vbnbharath/WSN/GPSLocalization/README.md

Scraps for testing GPS localization..
Approximate approach from "Localization of Wireless Sensor Networks with a Mobile Beacon by Mihail L. Sichitiu and Vaidyanathan Ramadurai"
http://ieeexplore.ieee.org/stamp/stamp.jsp?arnumber=1392104
Computer-side code written in Python
