vbnbharath/WSN/Documentation/latex/pin_defs_8h.tex

\hypertarget{pin_defs_8h}{}\section{pin\+Defs.\+h File Reference}
\label{pin_defs_8h}\index{pin\+Defs.\+h@{pin\+Defs.\+h}}
\subsection*{Macros}
\begin{DoxyCompactItemize}
\item 
\#define \hyperlink{pin_defs_8h_add3ca9eefe3b5b754426f51d3043e579}{True}~1
\item 
\#define \hyperlink{pin_defs_8h_a306ebd41c0cd1303b1372c6153f0caf8}{False}~0
\end{DoxyCompactItemize}

\subsection{Macro Definition Documentation}
\hypertarget{pin_defs_8h_a306ebd41c0cd1303b1372c6153f0caf8}{}\index{pin\+Defs.\+h@{pin\+Defs.\+h}!False@{False}}
\index{False@{False}!pin\+Defs.\+h@{pin\+Defs.\+h}}
\subsubsection[{False}]{\setlength{\rightskip}{0pt plus 5cm}\#define False~0}\label{pin_defs_8h_a306ebd41c0cd1303b1372c6153f0caf8}
\hypertarget{pin_defs_8h_add3ca9eefe3b5b754426f51d3043e579}{}\index{pin\+Defs.\+h@{pin\+Defs.\+h}!True@{True}}
\index{True@{True}!pin\+Defs.\+h@{pin\+Defs.\+h}}
\subsubsection[{True}]{\setlength{\rightskip}{0pt plus 5cm}\#define True~1}\label{pin_defs_8h_add3ca9eefe3b5b754426f51d3043e579}
