vbnbharath/WSN/hardware/antenna_node/sensor_node_schematic.pdf

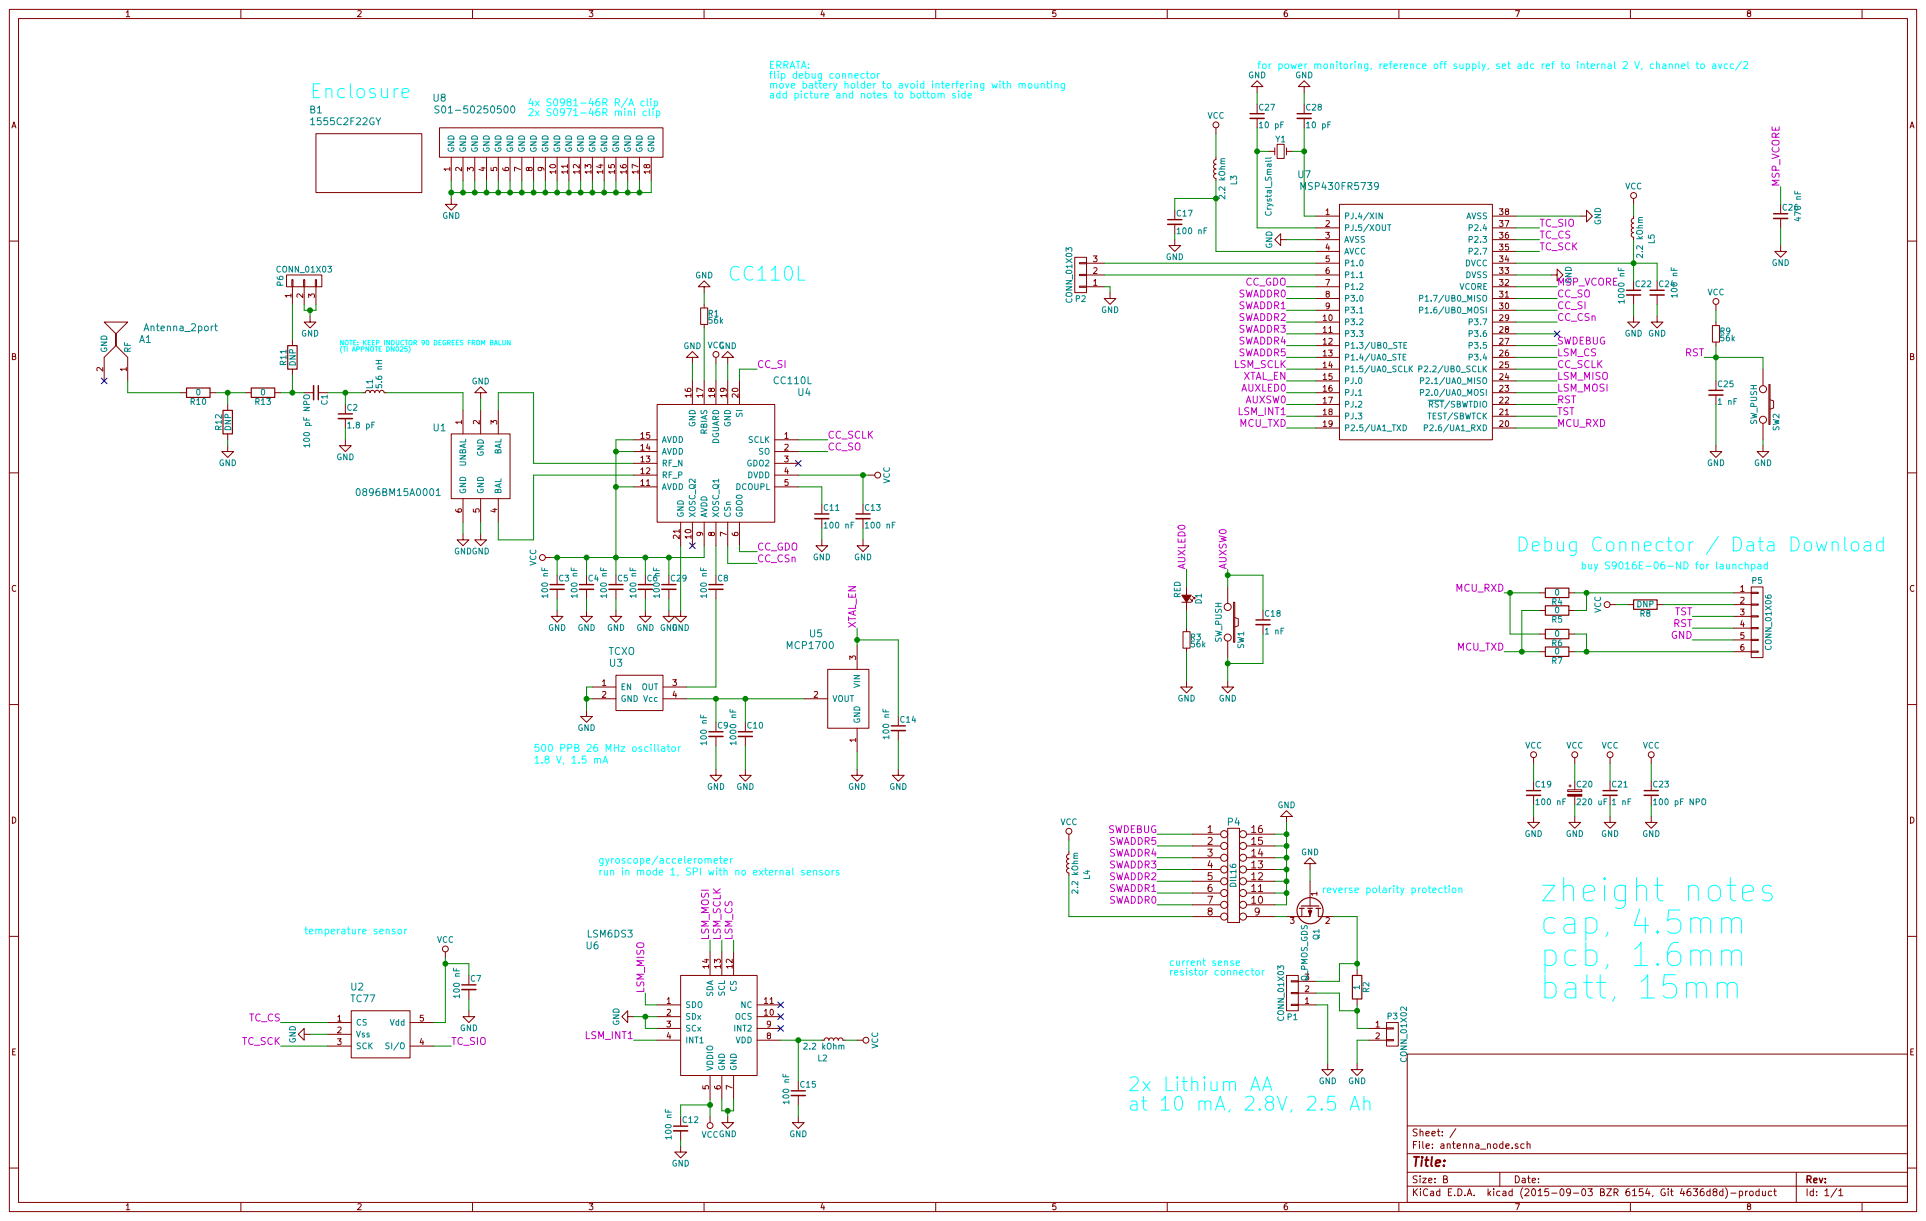
[picture p1: page 1]

for power monitoring, reference off supply, set adc ref to internal 2 V, channel to avcc/2 LSM_MISO

ERRATA:
flip debug connector
move battery holder to avoid interfering with mounting
add picture and notes to bottom side

9 GND 10 GND 11 GND 12 GND 13 GND 14 GND 15 GND 16 GND 17 GND 18 U8S01-50250500 GND

9 XOSC_Q2 10 SI 20 AVDD 11 GND 21 RF_P 12 RF_N 13 AVDD 14 AVDD 15 GND 16 RBIAS 17 DGUARD 18 GND 19U4 CC110L CC_GDO

NOTE: KEEP INDUCTOR 90 DEGREES FROM BALUN

Debug Connector / Data Download

C5 100 nFC3 100 nF GND GND GND

buy S9016E-06-ND for launchpad

run in mode 1, SPI with no external sensors LSM_MOSI LSM_SCLK LSM_CS temperature sensor
