vbnbharath/WSN/hardware/gps_breakout/gps_breakout.kicad_pcb

## KiCad design hardware/gps_breakout/gps_breakout.kicad_pcb (2015-10-24)

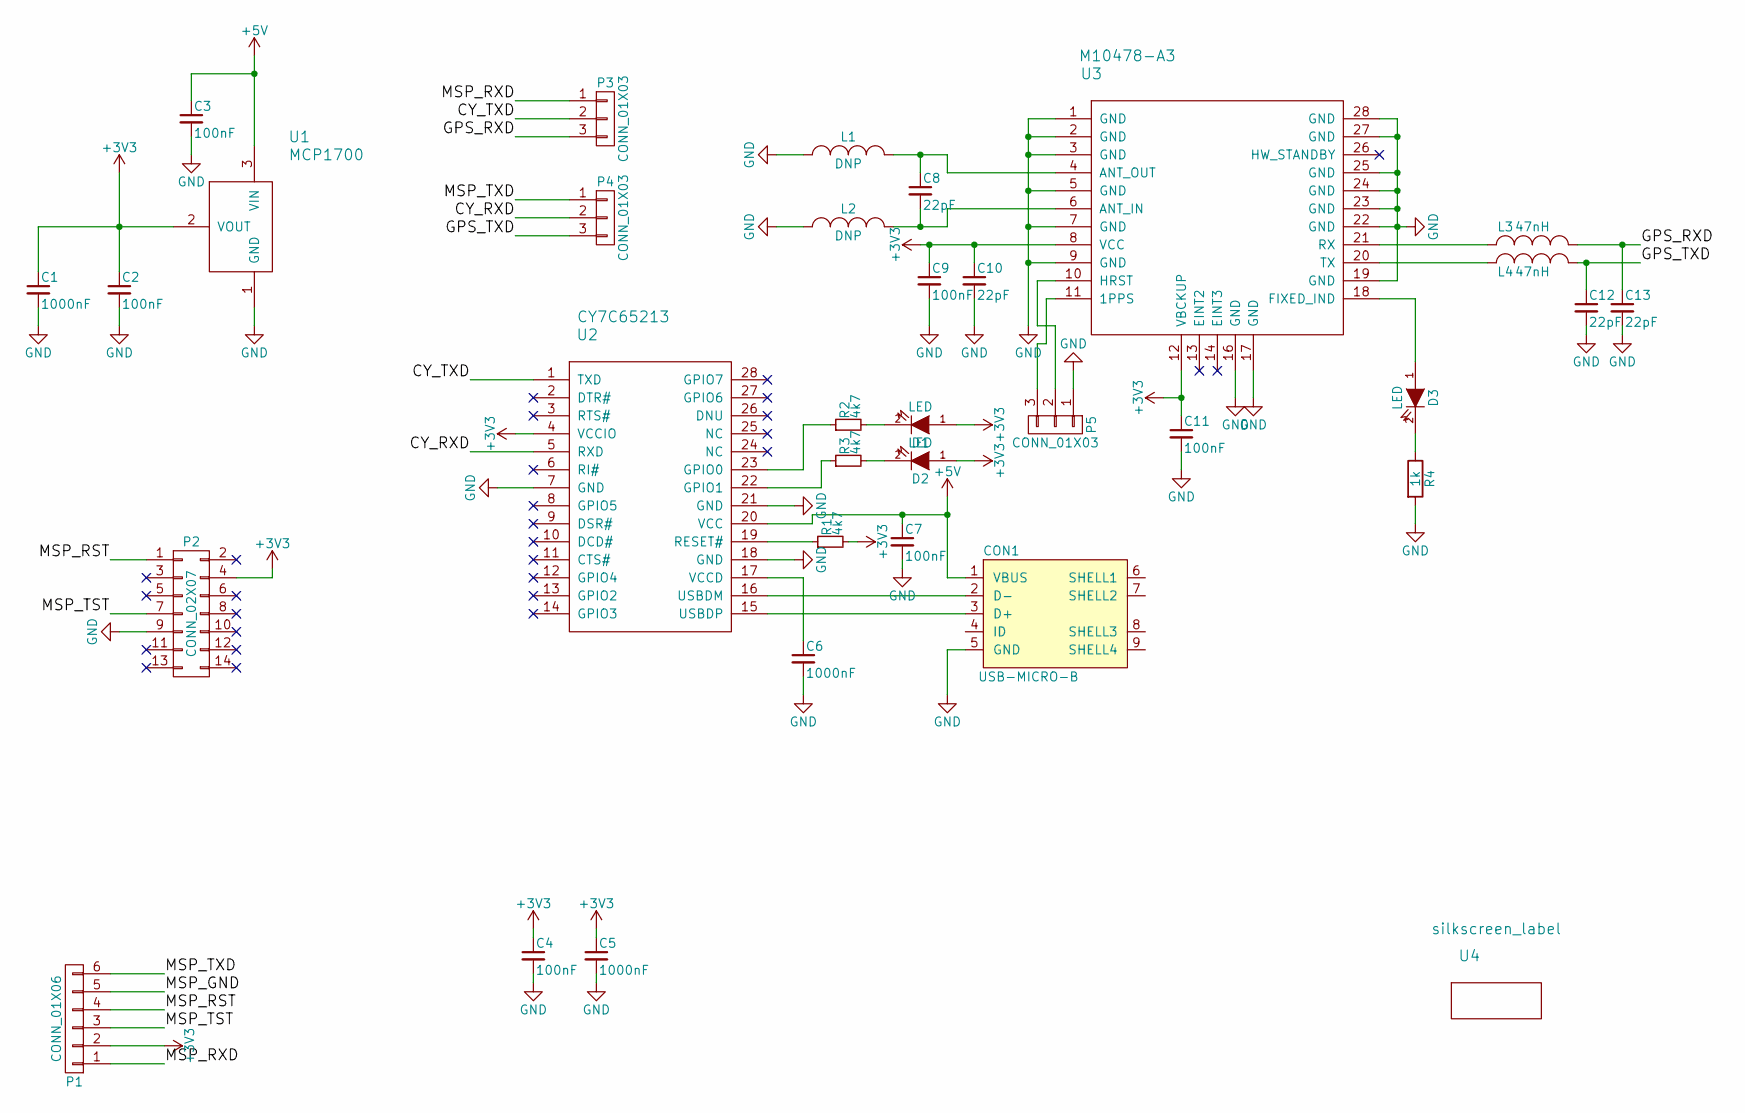
[picture p2: schematic gps_breakout.sch]

Parts:
C1, C5, C6: 1000nF; C_0603
C2, C3, C4, C7, C9, C11: 100nF; C_0603
C8, C10, C12, C13: 22pF; C_0603
CON1: USB-MICRO-B; USB_Mini-B
D1, D2, D3: LED; LED-0603
L1, L2: DNP; R_0603
L3, L4: 47nH; R_0603
P1: CONN_01X06; LPPB061NGCN-RC
P2: CONN_02X07; CONN_MSPJTAG
P3, P4, P5: CONN_01X03; JMP_HDR
R1, R2, R3: 4k7; R_0603
R4: 1k; R_0603
U1: MCP1700; SOT89-3_Housing
U2: CY7C65213; SSOP-28_5.3x10.2mm_Pitch0.65mm
U3: M10478-A3; gps_radionova
U4: silkscreen_label; gunter

Connections:
+3V3: C1.1, C2.1, C4.1, C5.1, C9.1, C10.1, C11.1, D1.1 (A), D2.1 (A), P1.2, P2.4, R1.2, U1.2 (VOUT), U2.4 (VCCIO), U3.8 (VCC), U3.12 (VBCKUP)
+5V: C3.1, C7.1, CON1.1 (VBUS), U1.3 (VIN), U2.20 (VCC)
/CY_RXD: P4.2, U2.5 (RXD)
/CY_TXD: P3.2, U2.1 (TXD)
/GPS_RXD: C13.1, L3.2, P3.3
/GPS_TXD: C12.1, L4.2, P4.3
/MSP_GND: P1.5
/MSP_RST: P1.4, P2.1
/MSP_RXD: P1.1, P3.1
/MSP_TST: P1.3, P2.7
/MSP_TXD: P1.6, P4.1
GND: C1.2, C2.2, C3.2, C4.2, C5.2, C6.2, C7.2, C9.2, C10.2, C11.2, C12.2, C13.2, CON1.5 (GND), L1.1, L2.1, P2.9, P5.1, R4.2, U1.1 (GND), U2.7 (GND), U2.18 (GND), U2.21 (GND), U3.1 (GND), U3.2 (GND), U3.3 (GND), U3.5 (GND), U3.7 (GND), U3.9 (GND), U3.16 (GND), U3.17 (GND), U3.19 (GND), U3.22 (GND), U3.23 (GND), U3.24 (GND), U3.25 (GND), U3.27 (GND), U3.28 (GND)
unnamed: C6.1, U2.17 (VCCD)
unnamed: C8.1, L1.2, U3.4 (ANT_OUT)
unnamed: C8.2, L2.2, U3.6 (ANT_IN)
unnamed: CON1.2 (D-), U2.16 (USBDM)
unnamed: CON1.3 (D+), U2.15 (USBDP)
unnamed: D1.2 (K), R2.2
unnamed: D2.2 (K), R3.2
unnamed: D3.1 (A), U3.18 (FIXED_IND)
unnamed: D3.2 (K), R4.1
unnamed: L3.1, U3.21 (RX)
unnamed: L4.1, U3.20 (TX)
unnamed: P5.2, U3.10 (HRST)
unnamed: P5.3, U3.11 (1PPS)
unnamed: R1.1, U2.19 (RESET#)
unnamed: R2.1, U2.23 (GPIO0)
unnamed: R3.1, U2.22 (GPIO1)

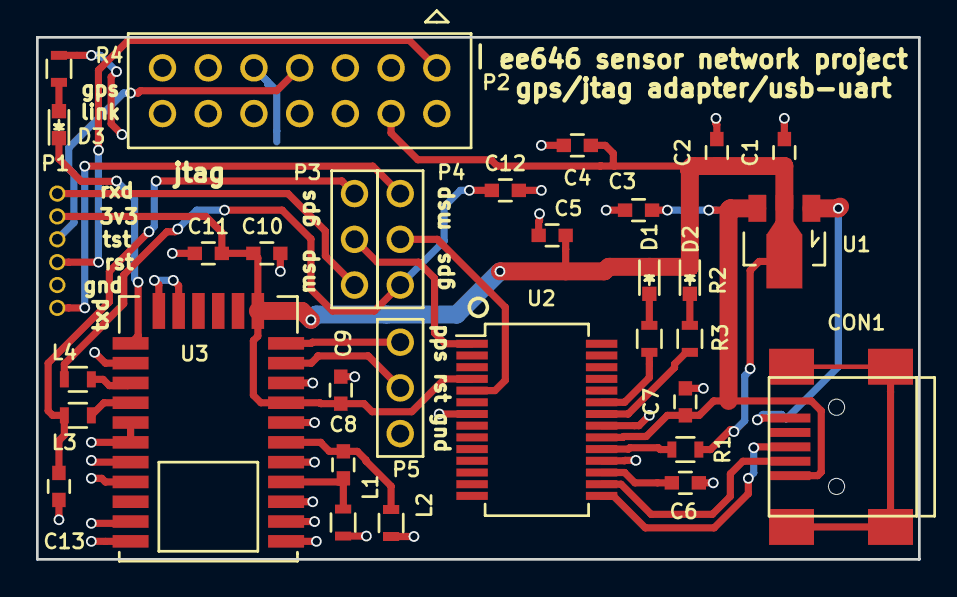
[picture p3: board gps_breakout.kicad_pcb from above]

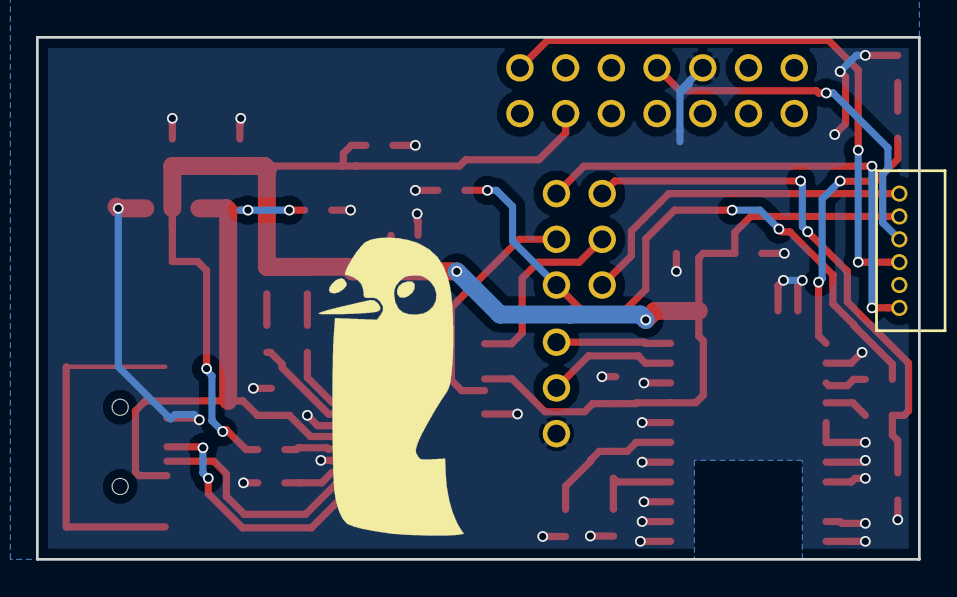
[picture p4: board gps_breakout.kicad_pcb from below]

Board: 2 copper layers, 49.0 x 29.0 mm, 34 parts (2 on the bottom side), 27 nets.
