vbnbharath/WSN/hardware/antenna_node/antenna_node.kicad_pcb

## KiCad design hardware/antenna_node/antenna_node.kicad_pcb (2015-10-14)

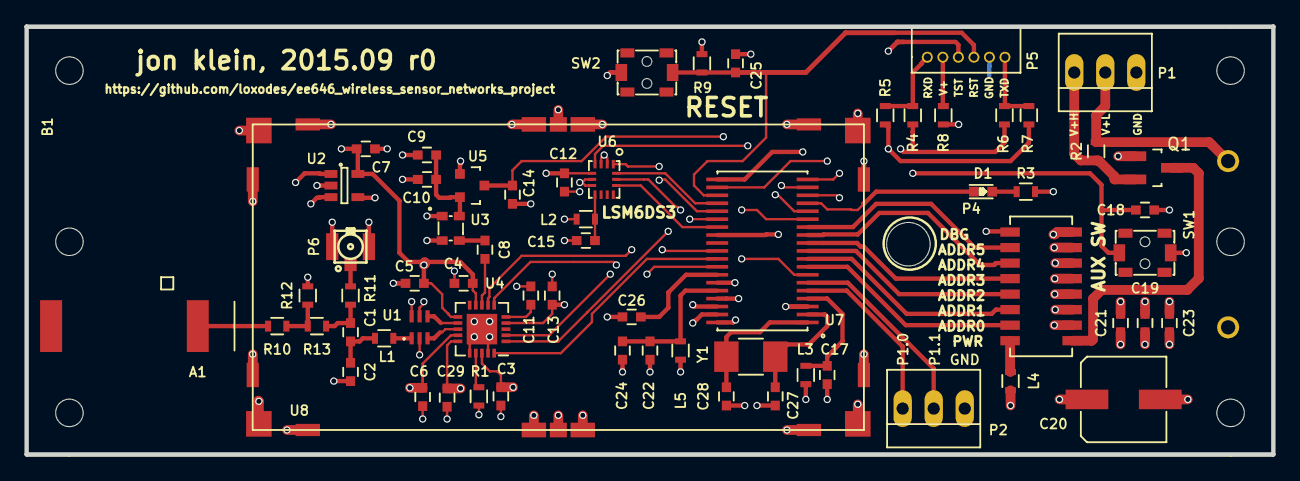
[picture p5: board antenna_node.kicad_pcb from above]

Board: 4 copper layers, 102.0 x 35.0 mm, 67 parts (1 on the bottom side), 58 nets.

Parts:
A1: Antenna_2port; ANT1204LL05R0915A
B1: 1555C2F22GY; 1555CF22
C1, C23: 100 pF NPO; C_0603
C2: 1.8 pF; C_0603
C3, C4, C5, C6, C7, C8, C9, C11, C12, C13, C14, C15, C17, C19, C24, C29: 100 nF; C_0603
C10, C22: 1000 nF; C_0603
C18, C21, C25: 1 nF; C_0603
C20: 220 uF; CAP_POL_6p60mm
C26: 470 nF; C_0603
C27, C28: 10 pF; C_0603
D1: RED; LED-0603
L1: 5.6 nH; R_0603
L2, L3, L4, L5: 2.2 kOhm; R_0603
P1, P2: CONN_01X03; PINHEAD1-3
P3: CONN_01X02; BC2AAPC
P4: DIL16; CHS-08TA
P5: CONN_01X06; LPPB061NGCN-RC
P6: CONN_01X03; U.FL-COAX
Q1: Q_PMOS_GDS; SOT-23_Handsoldering
R1, R3, R9: 56k; R_0603
R2: 1; R_0603
R4, R5, R6, R7, R10, R13: 0; R_0603
R8, R11, R12: DNP; R_0603
SW1, SW2: SW_PUSH; PTS820J20MSMTRLFS
U1: 0896BM15A0001; 0896BM15A0001E
U2: TC77; SOT-23-5
U3: TCXO; NT2016SA
U4: CC110L; QFN-20-1EP_4x4mm_Pitch0.5mm
U5: MCP1700; SOT-23
U6: LSM6DS3; ST_LGA_14
U7: MSP430FR5739; TSSOP_38_Pitch0.65mm
U8: S01-50250500
Y1: Crystal_Small; R_1210_HandSoldering

Connections:
/AUXLED0: D1.1, U7.16
/AUXSW0: C18.1, SW1.1, U7.17
/CC_CSn: U4.7, U7.29
/CC_GDO: U4.6, U7.7
/CC_SCLK: U4.1, U7.25
/CC_SI: U4.20, U7.30
/CC_SO: U4.2, U7.31
/LSM_CS: U6.12, U7.26
/LSM_INT1: U6.4, U7.18
/LSM_MISO: U6.1, U7.24
/LSM_MOSI: U6.14, U7.23
/LSM_SCLK: U6.13, U7.14
/MCU_RXD: R4.2, R6.2, U7.20
/MCU_TXD: R5.2, R7.2, U7.19
/MSP_VCORE: C26.1, U7.32
/RST: C25.1, P5.4, R9.2, SW2.1, U7.22
/SWADDR0: P4.7, U7.8
/SWADDR1: P4.6, U7.9
/SWADDR2: P4.5, U7.10
/SWADDR3: P4.4, U7.11
/SWADDR4: P4.3, U7.12
/SWADDR5: P4.2, U7.13
/SWDEBUG: P4.1, U7.27
/TC_CS: U2.1, U7.36
/TC_SCK: U2.3, U7.35
/TC_SIO: U2.4, U7.37
/TST: P5.3, U7.21
/XTAL_EN: C14.1, U5.3, U7.15
GND: C2.2, C3.2, C4.2, C5.2, C6.2, C7.2, C9.2, C10.2, C11.2, C12.2, C13.2, C14.2, C15.2, C17.2, C18.2, C19.2, C20.2, C21.2, C22.2, C23.2, C24.2, C25.2, C26.2, C27.1, C28.1, C29.2, P1.1, P2.1, P3.2, P4.10, P4.11, P4.12, P4.13, P4.14, P4.15, P4.16, P5.5, P6.2, P6.3, Q1.1, R1.1, R3.2, R12.1, SW1.2, SW2.2, U1.2, U1.5, U1.6, U2.2, U3.1, U3.2, U4.16, U4.19, U4.21, U5.1, U6.2, U6.3, U6.6, U6.7, U7.3, U7.33, U7.38, U8.1, U8.2, U8.3, U8.4, U8.5, U8.6, U8.7, U8.8, U8.9, U8.10, U8.11, U8.12, U8.13, U8.14, U8.15, U8.16, U8.17, U8.18
unnamed: A1.1, R10.2
unnamed: C1.1, C2.1, L1.1
unnamed: C1.2, R11.1, R13.1
unnamed: C8.1, U4.8
unnamed: C8.2, U3.3
unnamed: C9.1, C10.1, U3.4, U5.2
unnamed: C11.1, U4.5
unnamed: C15.1, L2.1, U6.8
unnamed: C17.1, L3.1, U7.4
unnamed: C22.1, C24.1, L5.1, U7.34
unnamed: C27.2, U7.2, Y1.1
unnamed: C28.2, U7.1, Y1.2
unnamed: D1.2, R3.1
unnamed: L1.2, U1.1
unnamed: L4.1, P4.8
unnamed: P1.2, P3.1, R2.2
unnamed: P1.3, Q1.2, R2.1
unnamed: P2.2, U7.6
unnamed: P2.3, U7.5
unnamed: P4.9, Q1.3
unnamed: P5.1, R4.1, R5.1
unnamed: P5.2, R8.1
unnamed: P5.6, R6.1, R7.1
unnamed: P6.1, R11.2
unnamed: R1.2, U4.17
unnamed: R10.1, R12.2, R13.2
unnamed: U1.3, U4.13
unnamed: U1.4, U4.12
VCC: C3.1, C4.1, C5.1, C6.1, C7.1, C12.1, C13.1, C19.1, C20.1, C21.1, C23.1, C29.1, L2.2, L3.2, L4.2, L5.2, R8.2, R9.1, U2.5, U4.4, U4.9, U4.11, U4.14, U4.15, U4.18, U6.5
