vbnbharath/WSN/GPSLocalization/rssi_grabber.py

# script for logging rssi and gps data for testing localization
# using a pair of MSP430s running the "WirelessTest" energia example
# and TI AIR BoosterPacks
# and a bluetooth GPS (e.g an android phone with the ShareGPS)

import bluetooth
import pynmea2
import sys
import datetime
import serial
import time
import csv 

GPS_ADDR = "08:D4:2B:1A:58:E9" # "BC:F5:AC:74:7C:93"#
GPS_PORT = 3
MIN_TIME = 5 # seconds

BLOCKING = False

# open up serial port for GPS, return pyserial object
def init_gps(port = GPS_PORT, addr = GPS_ADDR):
    print('connecting to GPS')
    socket = bluetooth.BluetoothSocket(bluetooth.RFCOMM)
    socket.connect((addr, port))
    print('connected to GPS')
    
    return socket 

def init_radio(port = 'COM14'):
    print('connecting to radio..')
    ser = serial.Serial(port, timeout = 1)
    return ser

# close radio serial
def close_radio(ser):
    ser.close()

# close GPS socket
def close_gps(socket):
    socket.close()

def get_rssi(ser):
    ser.flushInput() # get rid of stale rssi readings
    rssi = None
    while rssi == None:
        line = ser.readline()
        print(line)
        if line[:2] == 'RX':
            rssi = int(line.split(',')[-3]) # dBm?
            break

    return rssi

# read in data from GPS, return location from most recent GPGGA 
def get_location(gps):
    gps_data = ''
    print('reading in location')
    gps.setblocking(True)
    while True:
        try:
            d = gps.recv(8096)
            gps.setblocking(False)
        except IOError:
            break
        gps_data += d
        print d
        if not d:
            break
    
    gps_data = '\n'.join(gps_data.split('\n')[1:-1]) # :(
    
    nmea_stream_reader = pynmea2.NMEAStreamReader()
    gps_loc_msg = None
    
    for msg in gps_data.split('\n'):
        if len(str(msg)) > 50 and 'GPGGA' in msg:
            gps_loc_msg = pynmea2.parse(msg[:-1])
        
    if gps_loc_msg == None:
        return (0, 0, 0)
    
    return (gps_loc_msg.latitude, gps_loc_msg.longitude, gps_loc_msg.horizontal_dil)

   
if __name__ == '__main__':
    # create log file
    csvfilename = 'rssi_location_log_{}.csv'.format(int(time.time()))
    csvfile = open(csvfilename, 'wb') 
    csvwriter = csv.writer(csvfile)
    csvwriter.writerow(['time (s)', 'rssi (dBm)', 'longitude (deg)', 'latitude (deg)', 'error (dil)'])

    # init gps and radio
    gps = init_gps()
    msp_serial = init_radio()
    
    # grab a bunch of data
    while True:
        if BLOCKING:
            if 'n' in raw_input('take another measurement? [y]/n: '):
                break
        else:
            time.sleep(MIN_TIME)
        location = get_location(gps)
        rssi = get_rssi(msp_serial)
        sampletime = time.time()

        print('location: ' + str(location))
        print('rssi: ' + str(rssi))

        csvwriter.writerow([sampletime, rssi, location[0], location[1], location[2]])
        csvfile.flush()
        
    # close up
    csvfile.close()
    close_gps(gps)
    close_radio(msp_serial)
