vbnbharath/WSN/GPSLocalization/rssi_processor.py

# backend for localization processing

# grid

# localization model
import geopy
import numpy as np
import configparser
import time 
import simplekml

from gps_driver import init_gps, get_location, wait_for_fix
from radio_driver import init_radio, get_rssi

LAT = 0
LON = 1
ERR = 2

ADDR = 0
RSSI = 1

CONFIG_FILENAME = 'grid_config.cfg'

GPS_FREQUENCY = 1 # hz

# given a rssi and tx power, estimate the path length 
# (for more complex models, maybe include frequency, base station height..)

# define some propagation models
# maybe solve for attenuation coefficient, constant amplitude offset, and location
def freespace_dist_pdf(rssi, grid, txpower, error):
    return 0

class node():
    # take in a lat/long/err tuple for gps driver

    def __init__(self, addr):
        self.addr = addr
        self.measurements = {}

        self.lat = None
        self.lon = None
        self.err = None

    # adds a kml point to a given simplekml object
    def add_kml(self, kml):
        kml.newpoint(name = str(self.addr), coords = [(self.lat, self.lon)])

    def __str__(self):
        if self.lat != None:
            print('sensor node with addr: {}, location: ({},{}) error: {}'.format(self.addr, self.lat, self.lon, self.err))
        else:
            print('sensor node with addr: {}, no location'.format(self.addr))

    class measurement:
        def __init__(self, location, rssi):
        self.lat = location[LAT]
        self.lon = location[LON]
        self.err = location[ERR]
        self.rssi = rssi


class localizer():
    def __init__(self, gps_port, radio_port):
        self.gps = init_gps(gps_port)
        self.radio = init_radio(radio_port)
        self.node_measurements = {}
        self.location_time = 0

        # read in grid_config.cfg
        # create localization grid
        # if center is auto,
        # read in current location, center grid
    
    def wait_for_gps_fix(self):
        wait_for_fix(self.gps)
        self.get_location()
    
    # frequency of incoming rssi packets is far higher than the gps sampling rate
    # so, return an old gps value unless we are expecting a new one
    # a better way of doing this would maybe to make get_location non-blocking, and only update if it is succesful?
    def update_location(self):
        if self.location_time - time.time() > GPS_FREQUENCY:
            self.location = get_location(self.gps)
            self.location_time = time.time()

    # listen over the radio for another packet
    # record the rssi, gps error, and current location
    def add_measurement(self): 
        self.update_location()
        rssi_packet = get_rssi(self.radio)
        
        addr = rssi_packet[ADDR]
        rssi = rssi_packet[RSSI]

        if not addr in self.node_measurements:
            self.node_measurements[addr] = []

        self.node_measurements[addr].append(measurement(self.location, rssi, addr))
   
    def process_location_map(self):
        # process current measurements into a new map
        # use bayes approach to solve for location and transmit power
        # using sets of location and rssi
        # 

    def export_location_map(self, filename):
        kml = simplekml.Kml()
        
        for n in self.nodes:
            n.add_kml(kml)

        kml.save(filename)

    def print_location_map(self):
        print('current node locations: ')
        for n in self.nodes:
            print n

def main():
    gps_port = '/dev/ttyACM0'
    radio_port = '/dev/ttyACM1'
    

    # todo: automate serial port detection,
    # serial.tools.list_ports
    # prompt to plug in gps, then radio

    loc = localizer(gps_port, radio_port)

    loc.wait_for_gps_fix() 

    try:
        while(True):
            loc.add_measurement()
    
    loc.process_location_map()
    loc.print_location_map()



if __name__ == '__main__()':
    main()
