vbnbharath/WSN/Stikine/MSP_Init.h

/*
 * MSP_Value.h
 *
 *  Created on: Oct 19, 2015
 *      Author: cgoss
 */

#ifndef MSP_INIT_H_
#define MSP_INIT_H_

void Board_Init(void);
void Timer_Init(void);
void Radio_Init(void);

#endif /* MSP_VALUE_H_ */
