vbnbharath/WSN/jon_sandbox/TI_CC_hardware_board.h

/* --COPYRIGHT--,BSD
 * Copyright (c) 2011, Texas Instruments Incorporated
 * All rights reserved.
 *
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
 * *  Redistributions of source code must retain the above copyright
 *    notice, this list of conditions and the following disclaimer.
 *
 * *  Redistributions in binary form must reproduce the above copyright
 *    notice, this list of conditions and the following disclaimer in the
 *    documentation and/or other materials provided with the distribution.
 *
 * *  Neither the name of Texas Instruments Incorporated nor the names of
 *    its contributors may be used to endorse or promote products derived
 *    from this software without specific prior written permission.
 *
 * THIS SOFTWARE IS PROVIDED BY THE COPYRIGHT HOLDERS AND CONTRIBUTORS "AS IS"
 * AND ANY EXPRESS OR IMPLIED WARRANTIES, INCLUDING, BUT NOT LIMITED TO,
 * THE IMPLIED WARRANTIES OF MERCHANTABILITY AND FITNESS FOR A PARTICULAR
 * PURPOSE ARE DISCLAIMED. IN NO EVENT SHALL THE COPYRIGHT OWNER OR
 * CONTRIBUTORS BE LIABLE FOR ANY DIRECT, INDIRECT, INCIDENTAL, SPECIAL,
 * EXEMPLARY, OR CONSEQUENTIAL DAMAGES (INCLUDING, BUT NOT LIMITED TO,
 * PROCUREMENT OF SUBSTITUTE GOODS OR SERVICES; LOSS OF USE, DATA, OR PROFITS;
 * OR BUSINESS INTERRUPTION) HOWEVER CAUSED AND ON ANY THEORY OF LIABILITY,
 * WHETHER IN CONTRACT, STRICT LIABILITY, OR TORT (INCLUDING NEGLIGENCE OR
 * OTHERWISE) ARISING IN ANY WAY OUT OF THE USE OF THIS SOFTWARE,
 * EVEN IF ADVISED OF THE POSSIBILITY OF SUCH DAMAGE.
 * --/COPYRIGHT--*/
//----------------------------------------------------------------------------
//  Description:  This file contains definitions specific to the hardware board.
//  Specifically, the definitions include hardware connections with the
//  CCxxxx connector port, LEDs, and switches.
//
//  MSP430/CC1100-2500 Interface Code Library v1.0
//
//  K. Quiring
//  Texas Instruments, Inc.
//  July 2006
//  IAR Embedded Workbench v3.41
//----------------------------------------------------------------------------

#define TI_CC_LED_PxOUT         PJOUT
#define TI_CC_LED_PxDIR         PJDIR
#define TI_CC_LED1              BIT1
#define TI_CC_LED2              BIT1
#define TI_CC_LED3              BIT1
#define TI_CC_LED4              BIT1

#define TI_CC_SW_PxIN           P3IN
#define TI_CC_SW_PxIE           P3IE
#define TI_CC_SW_PxIES          P3IES
#define TI_CC_SW_PxIFG          P3IFG
#define TI_CC_SW_PxREN          P3REN
#define TI_CC_SW_PxOUT          P3OUT
#define TI_CC_SW1               BIT0
#define TI_CC_SW2               BIT1
#define TI_CC_SW3               BIT2 
#define TI_CC_SW4               BIT3

#define TI_CC_GDO0_PxOUT        P1OUT
#define TI_CC_GDO0_PxIN         P1IN
#define TI_CC_GDO0_PxDIR        P1DIR
#define TI_CC_GDO0_PxIE         P1IE
#define TI_CC_GDO0_PxIES        P1IES
#define TI_CC_GDO0_PxIFG        P1IFG
#define TI_CC_GDO0_PIN          BIT2

#define TI_CC_GDO1_PxOUT        P1OUT
#define TI_CC_GDO1_PxIN         P1IN
#define TI_CC_GDO1_PxDIR        P1DIR
#define TI_CC_GDO1_PIN          BIT7 

#define TI_CC_GDO2_PxOUT        P3OUT
#define TI_CC_GDO2_PxIN         P3IN
#define TI_CC_GDO2_PxDIR        P3DIR
#define TI_CC_GDO2_PIN          BIT6 

#define TI_CC_CSn_PxOUT         P3OUT
#define TI_CC_CSn_PxDIR         P3DIR
#define TI_CC_CSn_PIN           BIT7


//----------------------------------------------------------------------------
// Select which port will be used for interface to CCxxxx
//----------------------------------------------------------------------------
#define TI_CC_RF_SER_INTF       TI_CC_SER_INTF_BITBANG  // Interface to CCxxxx

//#define TI_CC_RF_SER_INTF       TI_CC_SER_INTF_USCIB0  // Interface to CCxxxx
