vbnbharath/WSN/GPSLocalization/test_localization.py

#!/usr/bin/python2
# test script for localization approach

# see http://www.stat.missouri.edu/~bayes/Obayes5_webfiles/ToutorialCourses/brunero.pdf

from pylab import *
from scipy.spatial import distance
import pdb


def db_to_lin(d):
    return (10 ** (np.double(d)/10))

def lin_to_db(d):
    return 10 * log10(d)

def lin_to_dbm(d):
    return lin_to_db(d * 1000)

def dbm_to_watt(d):
    return db_to_lin(d) / 1000
	
CELL_SIZE = 2 # meters
GRID_SIZE = 500 # meters
GRID_WIDTH = GRID_SIZE / CELL_SIZE
GRID_RANGE = np.arange(0, GRID_SIZE, CELL_SIZE)

MIN_SHADOW = 5 
MAX_SHADOW = 5
SHADOW_WIDTH = 1
SHADOW_RANGE = np.linspace(MIN_SHADOW, MAX_SHADOW, SHADOW_WIDTH)

MIN_PATH = 3
MAX_PATH = 3
PATH_WIDTH = 1 
PATH_RANGE = np.linspace(MIN_PATH, MAX_PATH, PATH_WIDTH)

MIN_TXPOWER = 0 # dBm
MAX_TXPOWER = 0 # dBm
TXPOWER_WIDTH = 1 
TXPOWER_RANGE = np.linspace(MIN_TXPOWER, MAX_TXPOWER, TXPOWER_WIDTH)
# scale from dBm to watts
TXPOWER_RANGE = dbm_to_watt(TXPOWER_RANGE) 
TXPOWER_RANGE = np.array([dbm_to_watt(MIN_TXPOWER)])

RSSI_MIN = -105 # dBm
RSSI_MAX = -25 # dBm
RSSI_RES = .5 # dB
RSSI_RANGE = np.arange(RSSI_MIN, RSSI_MAX, RSSI_RES)
RSSI_RANGE = dbm_to_watt(RSSI_RANGE) # convert from dBm to watts
RSSI_WIDTH = len(RSSI_RANGE)

DIST_MIN = 1 # M
DIST_MAX = ceil(np.sqrt(2 * GRID_SIZE ** 2)) # M
DIST_WIDTH = 128 
DIST_RANGE = np.linspace(DIST_MIN, DIST_MAX, DIST_WIDTH)
DIST_RES = DIST_MAX / DIST_WIDTH

NTARGETS = 1
NMEASUREMENTS = 15


# calculate the probability of an rssi given propagation model and distance
# txpow, rssi in watts
# path_loss is scaling factor for path loss in log normal shadowing model
# shadow is not done properly, should be scaled on rssi power.... 
def log_p_rssi_calc(rssi, dist, txpow, path_loss_exponent, shadow):
    # first, calculate nominal rssi given dist, txpow, path_loss_exponent
    # rssi_nom is in linear units
    rssi_nom = rssi_calc(dist, txpow, path_loss_exponent)
    
    # next, determine difference between rssi and calculated rssi dB
    rssi_diff_db = lin_to_dbm(rssi_nom) - lin_to_dbm(rssi)
    
    # then, find the probability of that difference using the given log normal shadowing propagation model 
    p = (1 / (shadow * np.sqrt(2 * np.pi))) * np.exp(-((rssi_diff_db**2)/(2 * (shadow ** 2)))) # pdf of normal

    # .. and return the log probability
    return log(p)


# calculates a random rssi given a distance and noise
# dist - distance in meters
# txpow - transmit power in dBm
# path - path loss exponent
# shadow - log shadowing parameter (dB)
def calc_random_rssi(dist, txpow, path, shadow):
    # calculate rssi
    rssi = rssi_calc(dist, txpow, path)

    # calculate noise scaling
    if shadow:
        noise = db_to_lin(np.random.normal(loc = 0, scale = shadow))
    else:
        noise = 1
    
    # return rssi scaled by log shadow noise
    return rssi * noise

def rssi_calc(dist, txpow, path):
    p_r = lin_to_dbm(txpow) - path * 10 * np.log10(dist)
    return dbm_to_watt(p_r)

def main():
    #np.random.seed(50)

    # create synthetic target
    x_target_actual = 140
    y_target_actual = 140
    
    txpow_actual = dbm_to_watt(0)
    shadow_actual = 5 # shadowing
    path_actual = 3 # path loss exponent
    
    print('synthetic target at ({},{})'.format(x_target_actual, y_target_actual))

    # lookup table of log probabilities
    # with p(rssi | distance, transmit power, shadowing, and path loss exponent)
    print('starting computation of p(rssi) lookup table')
    p_rssi_lookup = np.ones((RSSI_WIDTH, DIST_WIDTH, TXPOWER_WIDTH, PATH_WIDTH, SHADOW_WIDTH), dtype = np.float32)
    print('p_rssi_lookup size: {} mb').format(p_rssi_lookup.nbytes / 1024 / 1024)
    for (r_i, rssi) in enumerate(RSSI_RANGE):
        #print 'computing for rssi: {}'.format(rssi)
        for (d_i, dist) in enumerate(DIST_RANGE):
            for (t_i, txpow) in enumerate(TXPOWER_RANGE):
                for (p_i, path_loss) in enumerate(PATH_RANGE):
                    for (s_i, shadow) in enumerate(SHADOW_RANGE):
                        p = log_p_rssi_calc(rssi, dist, txpow, path_loss, shadow)
                        p_rssi_lookup[r_i][d_i][t_i][p_i][s_i] = p 

    # initialize location grid probability map
    # uniform prior, probably not the best assumption
    location_grid = np.ones((GRID_WIDTH, GRID_WIDTH, TXPOWER_WIDTH, PATH_WIDTH, SHADOW_WIDTH), dtype = np.float64)
    print('location grid size: {} mb').format(location_grid.nbytes / 1024 / 1024)
    p_prior = np.log(1.0/location_grid.size)
    location_grid = p_prior * location_grid

    rssi_grid = np.zeros((GRID_WIDTH, GRID_WIDTH, TXPOWER_WIDTH, PATH_WIDTH, SHADOW_WIDTH), dtype = np.float64)

    for meas in range(NMEASUREMENTS):
        print('computing measurement ' + str(meas))
        # create random synthetic measurement
        x_meas = np.random.randint(GRID_WIDTH) * CELL_SIZE
        y_meas = np.random.randint(GRID_WIDTH) * CELL_SIZE
        dist_actual = distance.euclidean((x_meas, y_meas), (x_target_actual, y_target_actual))
        rssi_meas = calc_random_rssi(dist_actual, txpow_actual, path_actual, shadow_actual)
        r_i = np.argmin(np.abs(RSSI_RANGE - rssi_meas))

        print('measuring from ({},{}), actual distance {}, with measured rssi of {}'.format(x_meas, y_meas, dist_actual, lin_to_dbm(rssi_meas)))
    
        print('measurement {}, rssi (actual) of {} dBm with dist {}'.format(meas, lin_to_dbm(rssi_calc(dist_actual, txpow_actual, path_actual)), dist_actual)) 

        for (x_i, x_look) in enumerate(GRID_RANGE):
            for (y_i, y_look) in enumerate(GRID_RANGE):
                dist = distance.euclidean((x_meas, y_meas), (x_look, y_look))
                d_i = np.argmin(np.abs(DIST_RANGE - dist))

                for (t_i, txpow) in enumerate(TXPOWER_RANGE):
                    for (p_i, path_loss) in enumerate(PATH_RANGE):
                        for (s_i, shadow) in enumerate(SHADOW_RANGE):
                            location_grid[x_i][y_i][t_i][p_i][s_i] += p_rssi_lookup[r_i][d_i][t_i][p_i][s_i]

                            rssi_grid[x_i][y_i][t_i][p_i][s_i] = lin_to_dbm(rssi_calc(dist, txpow, path_loss))

    
    #           now we have a grid with p(rssi | measurements, other parameters)
    #           examine grid, try to identify location, txpower, and propagation model? 
        grid = np.squeeze(location_grid.copy())

        imshow(grid)
        grid -= np.max(grid.flatten())
        grid[int(x_target_actual / CELL_SIZE)][int(y_target_actual / CELL_SIZE)] = np.min(grid.flatten())
        grid.flat[np.argmax(grid)] = np.min(grid.flatten()) 

        imshow(grid)
        show()
        clf()

if __name__ =='__main__':
    main()
