vbnbharath/WSN/(commit log)

2015-10-14 added (non-functional) code to use radios on sensor node hardware
2015-10-14 added kicad files for sensor node hardware
    [antenna_node.csv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]
2015-10-16 Changed to stdint numeric types. Added working SPI library to Stikine
2015-10-16 Fixed spinlock for CC110l wakeup on SPI
    [main.c]
2015-10-17 Added burst Send/Read to SPI library Adapted CC1100 Header file for CC110l and added it to project.
2015-10-17 Fixed an issue where the RX complete flag would not be cleared in the SPI_Read function. This could cause issues with read commands issued after a send or in rapid succession.
    [main.c]
2015-10-18 Added Strobe command to SPI library Got basic radio hello world program working, push button on one board to light up LED on another.
2015-10-19 blinking lights of radio works! (fixed bug in SPI..)
    [TI_CC_spi.c, main.c]
2015-10-20 Broke SPI pin defines into a separate library.
    [MSP_Init.c, MSP_Init.h, SPI_Library.c, SPI_Library.h, main.c]
2015-10-21 Changed pin settings to accommodate the external 32768 crystal.
2015-10-21 Added Status register read to SPI Library.
2015-10-21 Finished documenting the SPI library and included the doxygen output.
2015-10-22 added gps breakout schematic
    [gps_breakout.kicad_pcb, gps_breakout.sch]
2015-10-23 started layout of gps board
    [gps_breakout.kicad_pcb, gps_breakout.sch]
2015-10-24 finished layout of gps board
    [gps_breakout.kicad_pcb, gps_breakout.sch]
2015-10-24 ordered gps board
    [gps_breakout-B.Cu.gbr.gbl, gps_breakout-B.Mask.gbr.gbs, gps_breakout-B.SilkS.gbr.gbo, gps_breakout-Edge.Cuts.gbr.gko, gps_breakout-F.Cu.gbr.gtl, gps_breakout-F.Mask.gbr.gts, gps_breakout-F.SilkS.gbr.gto, gps_breakout.drl.xln]
2015-10-25 added BOM, ordered components
    [gps_breakout.csv, gps_breakout.sch]
2015-10-26 removed temp file
    [gps_breakout.sch]
2015-10-27 started on fine grained localization with GPS
    [grid_config.cfg]
2015-10-27 wrote (untested) GPS driver, started on localization
2015-10-30 work during class, added kml exporting of sensor map
2015-11-13 fixed p(rssi) lookup table generation
    [test_localization.py]
2015-11-18 Timer code version 1
2015-11-19 Added a line to enable global interrupts in the init function.
    SPI library now appears to be working.
2015-11-20 added schematic pdf for sensor node
2015-11-22 added rssi logs from walking around taku
    [rssi_location_log_1448223600.csv, rssi_location_log_1448229917.csv, rssi_location_log_1448230108.csv, rssi_location_log_1448230547.csv]
2015-11-25 Added base temperature measurement using automatic data transfer.
2015-11-25 Fixed an issue with sleep timer, TA0CCR1 was accidentally used in place of TA0CCTL1
    [sleep_timer.c]
2015-11-25 Fixed an issue with the sleep timer, where TA0CCR1 was accidentally used where TA0CCTL1 should have been
    [MSP_Init.c, sleep_timer.c]
2015-11-29 Got temperature measurements working.
